BastiBudde/TTSky26b_I2C-Slave-Sensor/test/fpga/Tang_Primer_25k_fpga_project/impl/gwsynthesis/test_syn.rpt.html

- Synthesis Messages
- Synthesis Details
- Resource
  - Resource Usage Summary
  - Resource Utilization Summary
- Timing
  - Clock Summary
  - Max Frequency Summary
  - Detail Timing Paths Informations

# Synthesis Messages

Report Title | GowinSynthesis Report
Design File | C:\Users\Basti\Documents\001-Master\SS26-FHW\Chip_Design\fpga\test\src\i2c_slave.v C:\Users\Basti\Documents\001-Master\SS26-FHW\Chip_Design\fpga\test\src\lfsr_writer.v C:\Users\Basti\Documents\001-Master\SS26-FHW\Chip_Design\fpga\test\src\reg_block.v C:\Users\Basti\Documents\001-Master\SS26-FHW\Chip_Design\fpga\test\src\top_level.v
GowinSynthesis Constraints File | ---
Tool Version | V1.9.11.03 Education
Part Number | GW5A-LV25MG121NC1/I0
Device | GW5A-25
Device Version | A
Created Time | Thu Jun 18 16:47:18 2026
Legal Announcement | Copyright (C)2014-2025 Gowin Semiconductor Corporation. ALL rights reserved.

# Synthesis Details

Top Level Module | top_level

Synthesis Process

Running parser:
CPU time = 0h 0m 0.109s, Elapsed time = 0h 0m 0.171s, Peak memory usage = 542.805MB
Running netlist conversion:
CPU time = 0h 0m 0s, Elapsed time = 0h 0m 0s, Peak memory usage = 0MB
Running device independent optimization:
Optimizing Phase 0: CPU time = 0h 0m 0.015s, Elapsed time = 0h 0m 0.006s, Peak memory usage = 542.805MB
Optimizing Phase 1: CPU time = 0h 0m 0s, Elapsed time = 0h 0m 0.002s, Peak memory usage = 542.805MB
Optimizing Phase 2: CPU time = 0h 0m 0s, Elapsed time = 0h 0m 0.008s, Peak memory usage = 542.805MB
Running inference:
Inferring Phase 0: CPU time = 0h 0m 0s, Elapsed time = 0h 0m 0.008s, Peak memory usage = 542.805MB
Inferring Phase 1: CPU time = 0h 0m 0s, Elapsed time = 0h 0m 0.005s, Peak memory usage = 542.805MB
Inferring Phase 2: CPU time = 0h 0m 0.031s, Elapsed time = 0h 0m 0.001s, Peak memory usage = 542.805MB
Inferring Phase 3: CPU time = 0h 0m 0s, Elapsed time = 0h 0m 0.001s, Peak memory usage = 542.805MB
Running technical mapping:
Tech-Mapping Phase 0: CPU time = 0h 0m 0.015s, Elapsed time = 0h 0m 0.028s, Peak memory usage = 542.805MB
Tech-Mapping Phase 1: CPU time = 0h 0m 0.031s, Elapsed time = 0h 0m 0.013s, Peak memory usage = 542.805MB
Tech-Mapping Phase 2: CPU time = 0h 0m 0.015s, Elapsed time = 0h 0m 0.004s, Peak memory usage = 542.805MB
Tech-Mapping Phase 3: CPU time = 0h 0m 0.468s, Elapsed time = 0h 0m 0.49s, Peak memory usage = 542.805MB
Tech-Mapping Phase 4: CPU time = 0h 0m 0.093s, Elapsed time = 0h 0m 0.104s, Peak memory usage = 542.805MB
Generate output files:
CPU time = 0h 0m 0.015s, Elapsed time = 0h 0m 0.024s, Peak memory usage = 542.805MB
Total Time and Memory Usage | CPU time = 0h 0m 0.791s, Elapsed time = 0h 0m 0.865s, Peak memory usage = 542.805MB

# Resource

## Resource Usage Summary

Resource | Usage
I/O Port | 4
I/O Buf | 4
IBUF | 3
IOBUF | 1
Register | 207
DFFSE | 9
DFFRE | 198
LUT | 243
LUT2 | 12
LUT3 | 87
LUT4 | 144
ALU | 11
ALU | 11
INV | 2
INV | 2

## Resource Utilization Summary

Resource | Usage | Utilization
Logic | 256(245 LUT, 11 ALU) / 23040 | 2%
Register | 207 / 23280 | <1%
--Register as Latch | 0 / 23280 | 0%
--Register as FF | 207 / 23280 | <1%
BSRAM | 0 / 56 | 0%

# Timing

## Clock Summary:

NO. | Clock Name | Type | Period | Frequency(MHz) | Rise | Fall | Source | Master | Object
1 | clk | Base | 40.000 | 25.000 | 0.000 | 20.000 | | | clk_ibuf/I

## Max Frequency Summary:

NO. | Clock Name | Constraint | Actual Fmax | Logic Level | Entity
1 | clk | 25.000(MHz) | 194.742(MHz) | 5 | TOP

## Detail Timing Paths Information

### Path 1

Path Summary:

Slack | 34.865
Data Arrival Time | 5.446
Data Required Time | 40.311
From | reg_block_a/registers_registers_RAMREG_0_G[26]_s2
To | i2c_inst/output_reg_2_s0
Launch Clk | clk[R]
Latch Clk | clk[R]

Data Arrival Path:

AT | DELAY | TYPE | RF | FANOUT | NODE
0.000 | 0.000 | | | | clk
0.000 | 0.000 | tCL | RR | 1 | clk_ibuf/I
0.000 | 0.000 | tINS | RR | 207 | clk_ibuf/O
0.375 | 0.375 | tNET | RR | 1 | reg_block_a/registers_registers_RAMREG_0_G[26]_s2/CLK
0.757 | 0.382 | tC2Q | RR | 2 | reg_block_a/registers_registers_RAMREG_0_G[26]_s2/Q
1.132 | 0.375 | tNET | RR | 1 | reg_block_a/registers_RAMOUT_14_G[0]_s6/I0
1.659 | 0.526 | tINS | RR | 1 | reg_block_a/registers_RAMOUT_14_G[0]_s6/F
2.034 | 0.375 | tNET | RR | 1 | reg_block_a/registers_RAMOUT_14_G[0]_s2/I1
2.170 | 0.136 | tINS | RR | 1 | reg_block_a/registers_RAMOUT_14_G[0]_s2/O
2.545 | 0.375 | tNET | RR | 1 | reg_block_a/registers_RAMOUT_14_G[0]_s0/I1
2.631 | 0.086 | tINS | RR | 1 | reg_block_a/registers_RAMOUT_14_G[0]_s0/O
3.006 | 0.375 | tNET | RR | 1 | i2c_inst/n260_s2/I0
3.533 | 0.526 | tINS | RR | 1 | i2c_inst/n260_s2/F
3.908 | 0.375 | tNET | RR | 1 | i2c_inst/n260_s3/I3
4.170 | 0.262 | tINS | RR | 1 | i2c_inst/n260_s3/F
4.545 | 0.375 | tNET | RR | 1 | i2c_inst/n260_s4/I0
5.071 | 0.526 | tINS | RR | 1 | i2c_inst/n260_s4/F
5.446 | 0.375 | tNET | RR | 1 | i2c_inst/output_reg_2_s0/D

Data Required Path:

AT | DELAY | TYPE | RF | FANOUT | NODE
40.000 | 0.000 | | | | clk
40.000 | 0.000 | tCL | RR | 1 | clk_ibuf/I
40.000 | 0.000 | tINS | RR | 207 | clk_ibuf/O
40.375 | 0.375 | tNET | RR | 1 | i2c_inst/output_reg_2_s0/CLK
40.311 | -0.064 | tSu | | 1 | i2c_inst/output_reg_2_s0

Path Statistics:

Clock Skew: | 0.000
Setup Relationship: | 40.000
Logic Level: | 5
Arrival Clock Path Delay: | cell: 0.000, 0.000%; route: 0.375, 100.000%
Arrival Data Path Delay: | cell: 2.064, 40.695%; route: 2.625, 51.762%; tC2Q: 0.382, 7.543%
Required Clock Path Delay: | cell: 0.000, 0.000%; route: 0.375, 100.000%

### Path 2

Path Summary:

Slack | 34.865
Data Arrival Time | 5.446
Data Required Time | 40.311
From | reg_block_a/registers_registers_RAMREG_0_G[27]_s2
To | i2c_inst/output_reg_3_s0
Launch Clk | clk[R]
Latch Clk | clk[R]

Data Arrival Path:

AT | DELAY | TYPE | RF | FANOUT | NODE
0.000 | 0.000 | | | | clk
0.000 | 0.000 | tCL | RR | 1 | clk_ibuf/I
0.000 | 0.000 | tINS | RR | 207 | clk_ibuf/O
0.375 | 0.375 | tNET | RR | 1 | reg_block_a/registers_registers_RAMREG_0_G[27]_s2/CLK
0.757 | 0.382 | tC2Q | RR | 2 | reg_block_a/registers_registers_RAMREG_0_G[27]_s2/Q
1.132 | 0.375 | tNET | RR | 1 | reg_block_a/registers_RAMOUT_21_G[0]_s6/I0
1.659 | 0.526 | tINS | RR | 1 | reg_block_a/registers_RAMOUT_21_G[0]_s6/F
2.034 | 0.375 | tNET | RR | 1 | reg_block_a/registers_RAMOUT_21_G[0]_s2/I1
2.170 | 0.136 | tINS | RR | 1 | reg_block_a/registers_RAMOUT_21_G[0]_s2/O
2.545 | 0.375 | tNET | RR | 1 | reg_block_a/registers_RAMOUT_21_G[0]_s0/I1
2.631 | 0.086 | tINS | RR | 1 | reg_block_a/registers_RAMOUT_21_G[0]_s0/O
3.006 | 0.375 | tNET | RR | 1 | i2c_inst/n259_s3/I0
3.533 | 0.526 | tINS | RR | 1 | i2c_inst/n259_s3/F
3.908 | 0.375 | tNET | RR | 1 | i2c_inst/n259_s4/I3
4.170 | 0.262 | tINS | RR | 1 | i2c_inst/n259_s4/F
4.545 | 0.375 | tNET | RR | 1 | i2c_inst/n259_s5/I0
5.071 | 0.526 | tINS | RR | 1 | i2c_inst/n259_s5/F
5.446 | 0.375 | tNET | RR | 1 | i2c_inst/output_reg_3_s0/D

Data Required Path:

AT | DELAY | TYPE | RF | FANOUT | NODE
40.000 | 0.000 | | | | clk
40.000 | 0.000 | tCL | RR | 1 | clk_ibuf/I
40.000 | 0.000 | tINS | RR | 207 | clk_ibuf/O
40.375 | 0.375 | tNET | RR | 1 | i2c_inst/output_reg_3_s0/CLK
40.311 | -0.064 | tSu | | 1 | i2c_inst/output_reg_3_s0

Path Statistics:

Clock Skew: | 0.000
Setup Relationship: | 40.000
Logic Level: | 5
Arrival Clock Path Delay: | cell: 0.000, 0.000%; route: 0.375, 100.000%
Arrival Data Path Delay: | cell: 2.064, 40.695%; route: 2.625, 51.762%; tC2Q: 0.382, 7.543%
Required Clock Path Delay: | cell: 0.000, 0.000%; route: 0.375, 100.000%

### Path 3

Path Summary:

Slack | 35.401
Data Arrival Time | 4.662
Data Required Time | 40.064
From | i2c_inst/state_1_s0
To | i2c_inst/reg_addr_0_s1
Launch Clk | clk[R]
Latch Clk | clk[R]

Data Arrival Path:

AT | DELAY | TYPE | RF | FANOUT | NODE
0.000 | 0.000 | | | | clk
0.000 | 0.000 | tCL | RR | 1 | clk_ibuf/I
0.000 | 0.000 | tINS | RR | 207 | clk_ibuf/O
0.375 | 0.375 | tNET | RR | 1 | i2c_inst/state_1_s0/CLK
0.757 | 0.382 | tC2Q | RR | 6 | i2c_inst/state_1_s0/Q
1.132 | 0.375 | tNET | RR | 1 | i2c_inst/n120_s5/I0
1.659 | 0.526 | tINS | RR | 1 | i2c_inst/n120_s5/F
2.034 | 0.375 | tNET | RR | 1 | i2c_inst/n120_s4/I0
2.560 | 0.526 | tINS | RR | 3 | i2c_inst/n120_s4/F
2.935 | 0.375 | tNET | RR | 1 | i2c_inst/reg_addr_7_s4/I1
3.451 | 0.516 | tINS | RR | 1 | i2c_inst/reg_addr_7_s4/F
3.826 | 0.375 | tNET | RR | 1 | i2c_inst/reg_addr_7_s3/I2
4.287 | 0.461 | tINS | RR | 8 | i2c_inst/reg_addr_7_s3/F
4.662 | 0.375 | tNET | RR | 1 | i2c_inst/reg_addr_0_s1/CE

Data Required Path:

AT | DELAY | TYPE | RF | FANOUT | NODE
40.000 | 0.000 | | | | clk
40.000 | 0.000 | tCL | RR | 1 | clk_ibuf/I
40.000 | 0.000 | tINS | RR | 207 | clk_ibuf/O
40.375 | 0.375 | tNET | RR | 1 | i2c_inst/reg_addr_0_s1/CLK
40.064 | -0.311 | tSu | | 1 | i2c_inst/reg_addr_0_s1

Path Statistics:

Clock Skew: | 0.000
Setup Relationship: | 40.000
Logic Level: | 5
Arrival Clock Path Delay: | cell: 0.000, 0.000%; route: 0.375, 100.000%
Arrival Data Path Delay: | cell: 2.030, 47.347%; route: 1.875, 43.732%; tC2Q: 0.382, 8.921%
Required Clock Path Delay: | cell: 0.000, 0.000%; route: 0.375, 100.000%

### Path 4

Path Summary:

Slack | 35.401
Data Arrival Time | 4.662
Data Required Time | 40.064
From | i2c_inst/state_1_s0
To | i2c_inst/reg_addr_1_s1
Launch Clk | clk[R]
Latch Clk | clk[R]

Data Arrival Path:

AT | DELAY | TYPE | RF | FANOUT | NODE
0.000 | 0.000 | | | | clk
0.000 | 0.000 | tCL | RR | 1 | clk_ibuf/I
0.000 | 0.000 | tINS | RR | 207 | clk_ibuf/O
0.375 | 0.375 | tNET | RR | 1 | i2c_inst/state_1_s0/CLK
0.757 | 0.382 | tC2Q | RR | 6 | i2c_inst/state_1_s0/Q
1.132 | 0.375 | tNET | RR | 1 | i2c_inst/n120_s5/I0
1.659 | 0.526 | tINS | RR | 1 | i2c_inst/n120_s5/F
2.034 | 0.375 | tNET | RR | 1 | i2c_inst/n120_s4/I0
2.560 | 0.526 | tINS | RR | 3 | i2c_inst/n120_s4/F
2.935 | 0.375 | tNET | RR | 1 | i2c_inst/reg_addr_7_s4/I1
3.451 | 0.516 | tINS | RR | 1 | i2c_inst/reg_addr_7_s4/F
3.826 | 0.375 | tNET | RR | 1 | i2c_inst/reg_addr_7_s3/I2
4.287 | 0.461 | tINS | RR | 8 | i2c_inst/reg_addr_7_s3/F
4.662 | 0.375 | tNET | RR | 1 | i2c_inst/reg_addr_1_s1/CE

Data Required Path:

AT | DELAY | TYPE | RF | FANOUT | NODE
40.000 | 0.000 | | | | clk
40.000 | 0.000 | tCL | RR | 1 | clk_ibuf/I
40.000 | 0.000 | tINS | RR | 207 | clk_ibuf/O
40.375 | 0.375 | tNET | RR | 1 | i2c_inst/reg_addr_1_s1/CLK
40.064 | -0.311 | tSu | | 1 | i2c_inst/reg_addr_1_s1

Path Statistics:

Clock Skew: | 0.000
Setup Relationship: | 40.000
Logic Level: | 5
Arrival Clock Path Delay: | cell: 0.000, 0.000%; route: 0.375, 100.000%
Arrival Data Path Delay: | cell: 2.030, 47.347%; route: 1.875, 43.732%; tC2Q: 0.382, 8.921%
Required Clock Path Delay: | cell: 0.000, 0.000%; route: 0.375, 100.000%

### Path 5

Path Summary:

Slack | 35.401
Data Arrival Time | 4.662
Data Required Time | 40.064
From | i2c_inst/state_1_s0
To | i2c_inst/reg_addr_2_s1
Launch Clk | clk[R]
Latch Clk | clk[R]

Data Arrival Path:

AT | DELAY | TYPE | RF | FANOUT | NODE
0.000 | 0.000 | | | | clk
0.000 | 0.000 | tCL | RR | 1 | clk_ibuf/I
0.000 | 0.000 | tINS | RR | 207 | clk_ibuf/O
0.375 | 0.375 | tNET | RR | 1 | i2c_inst/state_1_s0/CLK
0.757 | 0.382 | tC2Q | RR | 6 | i2c_inst/state_1_s0/Q
1.132 | 0.375 | tNET | RR | 1 | i2c_inst/n120_s5/I0
1.659 | 0.526 | tINS | RR | 1 | i2c_inst/n120_s5/F
2.034 | 0.375 | tNET | RR | 1 | i2c_inst/n120_s4/I0
2.560 | 0.526 | tINS | RR | 3 | i2c_inst/n120_s4/F
2.935 | 0.375 | tNET | RR | 1 | i2c_inst/reg_addr_7_s4/I1
3.451 | 0.516 | tINS | RR | 1 | i2c_inst/reg_addr_7_s4/F
3.826 | 0.375 | tNET | RR | 1 | i2c_inst/reg_addr_7_s3/I2
4.287 | 0.461 | tINS | RR | 8 | i2c_inst/reg_addr_7_s3/F
4.662 | 0.375 | tNET | RR | 1 | i2c_inst/reg_addr_2_s1/CE

Data Required Path:

AT | DELAY | TYPE | RF | FANOUT | NODE
40.000 | 0.000 | | | | clk
40.000 | 0.000 | tCL | RR | 1 | clk_ibuf/I
40.000 | 0.000 | tINS | RR | 207 | clk_ibuf/O
40.375 | 0.375 | tNET | RR | 1 | i2c_inst/reg_addr_2_s1/CLK
40.064 | -0.311 | tSu | | 1 | i2c_inst/reg_addr_2_s1

Path Statistics:

Clock Skew: | 0.000
Setup Relationship: | 40.000
Logic Level: | 5
Arrival Clock Path Delay: | cell: 0.000, 0.000%; route: 0.375, 100.000%
Arrival Data Path Delay: | cell: 2.030, 47.347%; route: 1.875, 43.732%; tC2Q: 0.382, 8.921%
Required Clock Path Delay: | cell: 0.000, 0.000%; route: 0.375, 100.000%
