BastiBudde/TTSky26b_I2C-Slave-Sensor/test/fpga/Tang_Primer_25k_fpga_project/impl/pnr/test.rpt.txt

//Copyright (C)2014-2025 Gowin Semiconductor Corporation.
//All rights reserved.

1. PnR Messages

  <Report Title>: PnR Report
  <Design File>: C:\Users\Basti\Documents\001-Master\SS26-FHW\Chip_Design\fpga\test\impl\gwsynthesis\test.vg
  <Physical Constraints File>: C:\Users\Basti\Documents\001-Master\SS26-FHW\Chip_Design\fpga\test\src\physical_constraint.cst
  <Timing Constraints File>: C:\Users\Basti\Documents\001-Master\SS26-FHW\Chip_Design\fpga\test\src\timing_constraints.sdc
  <Tool Version>: V1.9.11.03 Education
  <Part Number>: GW5A-LV25MG121NC1/I0
  <Device>: GW5A-25
  <Device Version>: A
  <Created Time>:Thu Jun 18 16:47:27 2026

2. PnR Details

  Running placement:
    Placement Phase 0: CPU time = 0h 0m 0.02s, Elapsed time = 0h 0m 0.02s
    Placement Phase 1: CPU time = 0h 0m 0.178s, Elapsed time = 0h 0m 0.178s
    Placement Phase 2: CPU time = 0h 0m 0.029s, Elapsed time = 0h 0m 0.029s
    Placement Phase 3: CPU time = 0h 0m 0.396s, Elapsed time = 0h 0m 0.396s
    Total Placement: CPU time = 0h 0m 0.623s, Elapsed time = 0h 0m 0.623s
 Running routing:
    Routing Phase 0: CPU time = 0h 0m 0s, Elapsed time = 0h 0m 0s
    Routing Phase 1: CPU time = 0h 0m 0.764s, Elapsed time = 0h 0m 0.764s
    Routing Phase 2: CPU time = 0h 0m 0.023s, Elapsed time = 0h 0m 0.022s
    Routing Phase 3: CPU time = 0h 0m 0s, Elapsed time = 0h 0m 0s
    Total Routing: CPU time = 0h 0m 0.787s, Elapsed time = 0h 0m 0.786s
 Generate output files:
    CPU time = 0h 0m 3s, Elapsed time = 0h 0m 3s

 Total Time and Memory Usage: CPU time = 0h 0m 4s, Elapsed time = 0h 0m 4s, Peak memory usage = 543MB

3. Resource Usage Summary

  --------------------------------------------------------------------------------
  Resources                   | Usage                               | Utilization
  --------------------------------------------------------------------------------
  Logic                       | 256/23040                           |  2%
    --LUT,ALU,ROM16           | 256(245 LUT, 11 ALU, 0 ROM16)       | -
    --SSRAM(RAM16)            | 0                                   | -
  Register                    | 207/23280                           |  <1%
    --Logic Register as Latch | 0/23040                             |  0%
    --Logic Register as FF    | 204/23040                           |  <1%
    --I/O Register as Latch   | 0/240                               |  0%
    --I/O Register as FF      | 3/240                               |  2%
  CLS                         | 200/11520                           |  2%
  I/O Port                    | 4/86                                |  5%
  I/O Buf                     | 4                                   | -
    --Input Buf               | 3                                   | -
    --Output Buf              | 0                                   | -
    --Inout Buf               | 1                                   | -
  ================================================================================

4. I/O Bank Usage Summary

  --------------------------------------
  I/O Bank  | Usage       | Utilization 
  --------------------------------------
  bank 0   | 0/6         | 0%          
  bank 1   | 0/10        | 0%          
  bank 2   | 2/12        | 17%         
  bank 3   | 0/4         | 0%          
  bank 4   | 0/11        | 0%          
  bank 5   | 1/13        | 8%          
  bank 6   | 0/10        | 0%          
  bank 7   | 1/16        | 7%          
  bank 10  | 0/4         | 0%          
  ======================================

5. Clock Resource Usage Summary

  ------------------------------------------
  Clock Resource| Usage         | Utilization 
  ------------------------------------------
  PRIMARY       | 1/8           | 13%
  LW            | 1/8           | 13%
  GCLK_PIN      | 2/30          | 7%
  ==========================================

6. Global Clock Signals

  -------------------------------------------
  Signal         | Global Clock   | Location
  -------------------------------------------
  clk_d          | PRIMARY        |  TR TL BR BL
  RST_d          | LW             |  -
  ===========================================

7. Pinout by Port Name

------------------------------------------------------------------------------------------------------------------------------------------------------------------------------------------------------------------
Port Name  | Diff Pair | Loc./Bank     | Constraint | Dir.  | Site     | CFG             | IO Type    | Drive | Pull Mode | PCI Clamp | Hysteresis | Open Drain | Vref       | Single Resistor | Diff Resistor | BankVccio  | Pull Strength | Ctle         
------------------------------------------------------------------------------------------------------------------------------------------------------------------------------------------------------------------
clk        | -         | E2/5          | Y          | in    | IOB12[A] | GCLKT_10B/D07/SSPI_WPN/SSI2 | LVCMOS33   | OFF   | NONE      | OFF       | ON         | OFF        | OFF        | OFF             | OFF           | 3.3        | MEDIUM        | NONE         
RST        | -         | H11/7         | Y          | in    | IOT3[A]  | GCLKT_16        | LVCMOS33   | OFF   | DOWN      | OFF       | ON         | OFF        | OFF        | OFF             | OFF           | 3.3        | MEDIUM        | NONE         
SCL        | -         | K2/2          | Y          | in    | IOR20[B] | -               | LVCMOS33   | OFF   | UP        | OFF       | ON         | OFF        | OFF        | OFF             | OFF           | 3.3        | MEDIUM        | NONE         
SDA        | -         | K1/2          | Y          | io    | IOR20[A] | -               | LVCMOS33   | 8     | UP        | OFF       | OFF        | OFF        | OFF        | OFF             | OFF           | 3.3        | MEDIUM        | NONE         
==================================================================================================================================================================================================================

8. All Package Pins

------------------------------------------------------------------------------------------------------------------------------------------------------------------------------------
Loc./Bank| Signal  | Dir.  | Site     | CFG             | IO Type  | Drive | Pull Mode | PCI Clamp | Hysteresis | Open Drain | Vref       | Single Resistor | Diff Resistor | Bank Vccio | Pull Strength | Ctle         
------------------------------------------------------------------------------------------------------------------------------------------------------------------------------------
J11/7    | -       | in    | IOT1[A]  | GCLKT_15/LPLL0_T_IN0 | LVCMOS33 | 8     | UP        | OFF       | ON         | OFF        | OFF        | OFF             | OFF           | 3.3   | MEDIUM        | NONE         
J10/7    | -       | in    | IOT1[B]  | GCLKC_15        | LVCMOS33 | 8     | UP        | OFF       | ON         | OFF        | OFF        | OFF             | OFF           | 3.3   | MEDIUM        | NONE         
H11/7    | RST     | in    | IOT3[A]  | GCLKT_16        | LVCMOS33 | OFF   | DOWN      | OFF       | ON         | OFF        | OFF        | OFF             | OFF           | 3.3   | MEDIUM        | NONE         
H10/7    | -       | in    | IOT3[B]  | GCLKC_16        | LVCMOS33 | 8     | UP        | OFF       | ON         | OFF        | OFF        | OFF             | OFF           | 3.3   | MEDIUM        | NONE         
G11/7    | -       | in    | IOT7[A]  | -               | LVCMOS33 | 8     | UP        | OFF       | ON         | OFF        | OFF        | OFF             | OFF           | 3.3   | MEDIUM        | NONE         
G10/7    | -       | in    | IOT7[B]  | -               | LVCMOS33 | 8     | UP        | OFF       | ON         | OFF        | OFF        | OFF             | OFF           | 3.3   | MEDIUM        | NONE         
K11/7    | -       | in    | IOT11[A] | -               | LVCMOS33 | 8     | UP        | OFF       | ON         | OFF        | OFF        | OFF             | OFF           | 3.3   | MEDIUM        | NONE         
L11/7    | -       | in    | IOT11[B] | -               | LVCMOS33 | 8     | UP        | OFF       | ON         | OFF        | OFF        | OFF             | OFF           | 3.3   | MEDIUM        | NONE         
L10/7    | -       | in    | IOT15[A] | -               | LVCMOS33 | 8     | UP        | OFF       | ON         | OFF        | OFF        | OFF             | OFF           | 3.3   | MEDIUM        | NONE         
K10/7    | -       | in    | IOT15[B] | -               | LVCMOS33 | 8     | UP        | OFF       | ON         | OFF        | OFF        | OFF             | OFF           | 3.3   | MEDIUM        | NONE         
L7/7     | -       | in    | IOT19[A] | -               | LVCMOS33 | 8     | UP        | OFF       | ON         | OFF        | OFF        | OFF             | OFF           | 3.3   | MEDIUM        | NONE         
L8/7     | -       | in    | IOT19[B] | -               | LVCMOS33 | 8     | UP        | OFF       | ON         | OFF        | OFF        | OFF             | OFF           | 3.3   | MEDIUM        | NONE         
K7/7     | -       | in    | IOT21[A] | -               | LVCMOS33 | 8     | UP        | OFF       | ON         | OFF        | OFF        | OFF             | OFF           | 3.3   | MEDIUM        | NONE         
J7/7     | -       | in    | IOT21[B] | -               | LVCMOS33 | 8     | UP        | OFF       | ON         | OFF        | OFF        | OFF             | OFF           | 3.3   | MEDIUM        | NONE         
L6/7     | -       | in    | IOT23[A] | -               | LVCMOS33 | 8     | UP        | OFF       | ON         | OFF        | OFF        | OFF             | OFF           | 3.3   | MEDIUM        | NONE         
K6/7     | -       | in    | IOT23[B] | -               | LVCMOS33 | 8     | UP        | OFF       | ON         | OFF        | OFF        | OFF             | OFF           | 3.3   | MEDIUM        | NONE         
L9/0     | -       | in    | IOT31[A] | -               | LVCMOS33 | 8     | UP        | OFF       | ON         | OFF        | OFF        | OFF             | OFF           | 3.3   | MEDIUM        | NONE         
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
B1_B10A/5 | -       | in    | IOB10[A] | D03/SSPI_CS_N   | LVCMOS33 | 8     | UP        | OFF       | ON         | OFF        | OFF        | OFF             | OFF           | 3.3   | MEDIUM        | NONE         
A3_B10B/5 | -       | in    | IOB10[B] | D04/SI/SSI0     | LVCMOS33 | 8     | UP        | OFF       | ON         | OFF        | OFF        | OFF             | OFF           | 3.3   | MEDIUM        | NONE         
E2/5     | clk     | in    | IOB12[A] | GCLKT_10B/D07/SSPI_WPN/SSI2 | LVCMOS33 | OFF   | NONE      | OFF       | ON         | OFF        | OFF        | OFF             | OFF           | 3.3   | MEDIUM        | NONE         
E1/5     | -       | in    | IOB12[B] | GCLKC_10B/RDWR_B/LPLL1_C_IN1 | LVCMOS33 | 8     | DOWN      | OFF       | ON         | OFF        | OFF        | OFF             | OFF           | 3.3   | MEDIUM        | NONE         
C1_B14A/5 | -       | in    | IOB14[A] | SSPI_CLK        | LVCMOS33 | 8     | UP        | OFF       | ON         | OFF        | OFF        | OFF             | OFF           | 3.3   | MEDIUM        | NONE         
D1/5     | -       | in    | IOB14[B] | CLKHOLD_N/SSI3  | LVCMOS33 | 8     | UP        | OFF       | ON         | OFF        | OFF        | OFF             | OFF           | 3.3   | MEDIUM        | NONE         
A1/5     | -       | in    | IOB24[A] | -               | LVCMOS33 | 8     | UP        | OFF       | ON         | OFF        | OFF        | OFF             | OFF           | 3.3   | MEDIUM        | NONE         
F2/5     | -       | in    | IOB26[A] | GCLKT_9B        | LVCMOS33 | 8     | UP        | OFF       | ON         | OFF        | OFF        | OFF             | OFF           | 3.3   | MEDIUM        | NONE         
F1/5     | -       | in    | IOB26[B] | GCLKC_9B        | LVCMOS33 | 8     | UP        | OFF       | ON         | OFF        | OFF        | OFF             | OFF           | 3.3   | MEDIUM        | NONE         
E8/4     | -       | in    | IOB37[A] | READY           | LVCMOS33 | 8     | UP        | OFF       | ON         | OFF        | OFF        | OFF             | OFF           | 3.3   | MEDIUM        | NONE         
E6/4     | -       | in    | IOB37[B] | MCS_N/CSO_B     | LVCMOS33 | 8     | UP        | OFF       | ON         | OFF        | OFF        | OFF             | OFF           | 3.3   | MEDIUM        | NONE         
D5/4     | -       | in    | IOB54[A] | GCLKT_11B/D01/MI2 | LVCMOS33 | 8     | UP        | OFF       | ON         | OFF        | OFF        | OFF             | OFF           | 3.3   | MEDIUM        | NONE         
E4/4     | -       | in    | IOB54[B] | GCLKC_11B/D02/MI3/BPLL_C_FB1 | LVCMOS33 | 8     | UP        | OFF       | ON         | OFF        | OFF        | OFF             | OFF           | 3.3   | MEDIUM        | NONE         
B3/4     | -       | in    | IOB56[A] | -               | LVCMOS33 | 8     | UP        | OFF       | ON         | OFF        | OFF        | OFF             | OFF           | 3.3   | MEDIUM        | NONE         
C3/4     | -       | in    | IOB56[B] | -               | LVCMOS33 | 8     | UP        | OFF       | ON         | OFF        | OFF        | OFF             | OFF           | 3.3   | MEDIUM        | NONE         
E5/4     | -       | in    | IOB58[A] | D00/DIN/MISO/MI1 | LVCMOS33 | 8     | UP        | OFF       | ON         | OFF        | OFF        | OFF             | OFF           | 3.3   | MEDIUM        | NONE         
D6/4     | -       | in    | IOB58[B] | MOSI/MI0/CSI_B  | LVCMOS33 | 8     | UP        | OFF       | ON         | OFF        | OFF        | OFF             | OFF           | 3.3   | MEDIUM        | NONE         
E3/4     | -       | in    | IOB60[A] | -               | LVCMOS33 | 8     | UP        | OFF       | ON         | OFF        | OFF        | OFF             | OFF           | 3.3   | MEDIUM        | NONE         
E7/4     | -       | in    | IOB62[A] | CCLK            | LVCMOS33 | 8     | UP        | OFF       | ON         | OFF        | OFF        | OFF             | OFF           | 3.3   | MEDIUM        | NONE         
D7/4     | -       | in    | IOB64[A] | DONE            | LVCMOS33 | 8     | UP        | OFF       | ON         | OFF        | OFF        | OFF             | OFF           | 3.3   | MEDIUM        | NONE         
G4/3     | -       | in    | IOB89[A] | GCLKT_7/BPLL_T_IN0 | LVCMOS33 | 8     | UP        | OFF       | ON         | OFF        | OFF        | OFF             | OFF           | 3.3   | MEDIUM        | NONE         
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
====================================================================================================================================================================================
