BastiBudde/TTSky26b_I2C-Slave-Sensor/test/fpga/Tang_Primer_25k_fpga_project/impl/gwsynthesis/test_syn_resource.html

# Hierarchy Module Resource

MODULE NAME | REG NUMBER | ALU NUMBER | LUT NUMBER | DSP NUMBER | BSRAM NUMBER | SSRAM NUMBER | ROM16 NUMBER
top_level (C:/Users/Basti/Documents/001-Master/SS26-FHW/Chip_Design/fpga/test/src/top_level.v) | - | - | - | - | - | - | -
|--i2c_inst (C:/Users/Basti/Documents/001-Master/SS26-FHW/Chip_Design/fpga/test/src/top_level.v) | 49 | - | 80 | - | - | - | -
|--lfsr_inst (C:/Users/Basti/Documents/001-Master/SS26-FHW/Chip_Design/fpga/test/src/top_level.v) | 29 | 11 | 18 | - | - | - | -
|--reg_block_a (C:/Users/Basti/Documents/001-Master/SS26-FHW/Chip_Design/fpga/test/src/top_level.v) | 64 | - | 105 | - | - | - | -
|--reg_block_b (C:/Users/Basti/Documents/001-Master/SS26-FHW/Chip_Design/fpga/test/src/top_level.v) | 64 | - | 42 | - | - | - | -
|--reg_block_c (C:/Users/Basti/Documents/001-Master/SS26-FHW/Chip_Design/fpga/test/src/top_level.v) | 1 | - | - | - | - | - | -
