BastiBudde/TTSky26b_I2C-Slave-Sensor/(commit log)

2026-06-09 Migrated from 'ttsky-verilog-template' to 'ttgf-verilog-template'
    [pin_order.cfg]
2026-06-18 Added source codes for fpga testing (Gowin FPGA Designer project and ESP-IDF project for ESP32-C6 as I2C-Master)
    [device.cfg]
2026-06-18 Inserted dumpfile() ans dumpvars() statements in tb.v
2026-06-19 Finished fpga_report
    [device.cfg]
